thedrgreenthumb/dsPICAudioEffects/doc/dsPIC33AudioEffectsPedalPaper.pdf

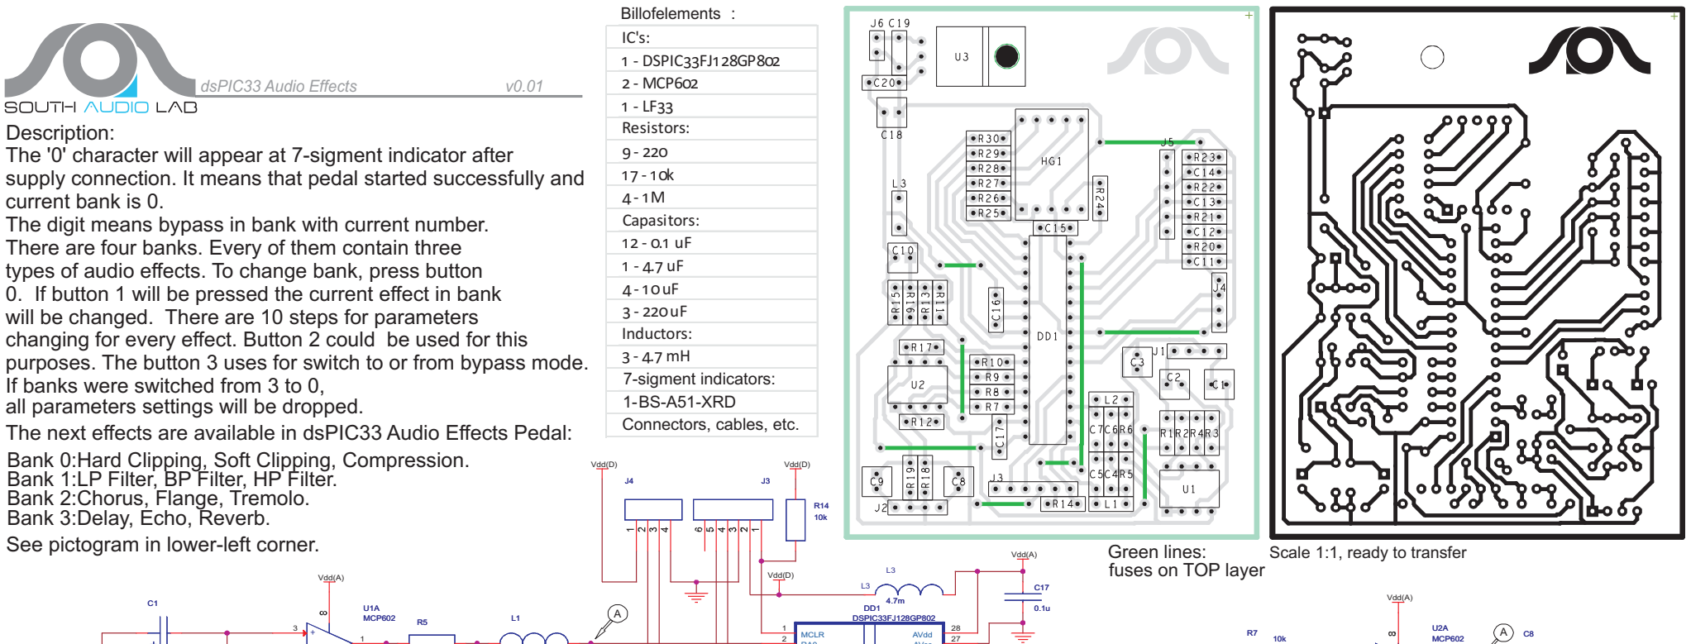
[picture p1: figure]
IC's: 1 - DSPIC33FJ128GP802 2 - MCP602 1 - LF33 Resistors: 9- 220 17 - 10k 4- 1Ì Capasitors: 12 - 0.1 uF 1 - 4.7 uF 4- 10uF 3 - 220uF Inductors: 3 - 4.7 mH; Green lines:; Scale 1:1, ready to transfer; fuses on TOP layer Vdd(A); Vdd(A); Vdd(D); DD1 DSPIC33FJ128GP802; U1A MCP602; Billofelements :; dsPIC33 Audio Effects; Bank 2:Chorus, Flange, Tremolo.; See pictogram in lower-left corner.; Description:; 7-sigment indicators: 1-BS-A51-XRD Connectors, cables, etc.; Bank 1:LP Filter, BP Filter, HP Filter.; Bank 3:Delay, Echo, Reverb.

Vdd(A)

Vdd(A)

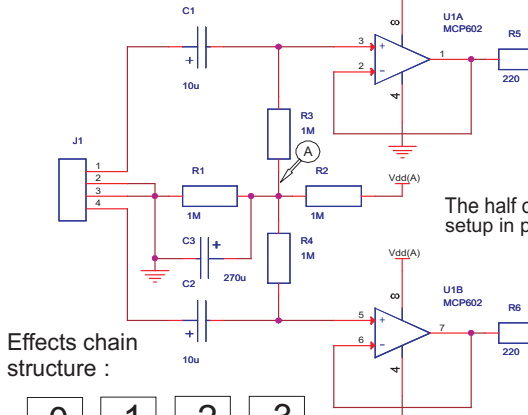
[picture p2: figure]
Vdd(A); U1B MCP602; Effects chain structure :

Vdd(D) | Vdd(D) | Vdd(D) | Vdd(D)

Vdd(D)

Vdd(D)

Vdd(D)

C4

0.1u

C9

10u

C20

0.1u

R20
10k

R26

220

C10

270u

R23
10k

+

MCP602
3

2

1

R30

220

C11

0.1u

C5

0.1u

R21
10k

R10
10k

C13

0.1u

MCLR
RA0

2

RA1

3

RB0/PGED1

4

RB1/PGEC1

5

RB2

6

RB3

7

Vss

8

OSC1/RA2

9

OSC2/RA3

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
15 RB7

16 RB8

17 RB9

18 Vss

19 Vddcore

20 RB10

21 RB11

22 RB12

23 RB13

24 RB14

25 RB15

26 AVss

27 AVdd

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
BS-A51XRD

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
0.1u

R27

220

J6

1
2

+

U2B
MCP602
5

6

7

C12

0.1u

C14

0.1u

+ | C18
| 270u

R16
10k

C7

0.1u

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
U3 LF33/TO220

VOUT

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
4.7m

C16

4.7u

C15

0.1u

R18
10k

C19

0.1u

L2

4.7m

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
J5 - Buttons.

J3 - ICSP.

*C16 ust be
ceramic

m

*

À

À

À

The half of supply voltage must be setup in points with character A

-C

-L
-E

-2

-F
-t

-C

The '0' character will appear at 7-sigment indicator after
supply connection. It means that pedal started successfully and current bank is 0.
The digit means bypass in bank with current number.
There are four banks. Every of them contain three
types of audio effects. To change bank, press button
0. If button 1 will be pressed the current effect in bank
will be changed. There are 10 steps for parameters
changing for every effect. Button 2 could be used for this purposes. The button 3 uses for switch to or from bypass mode. If banks were switched from 3 to 0,

The next effects are available in dsPIC33 Audio Effects Pedal: Bank 0:Hard Clipping, Soft Clipping, Compression.

all parameters settings will be dropped.

J4 - UART.
