thedrgreenthumb/dsPICAudioEffects/(list of files, drawings)

Other design files:
altium/final pedal1.PcbLib
altium/final pedal axial 03.PcbDoc
altium/final pedal.PcbDoc
altium/final pedal.PcbLib
altium/gui/gui.PcbDoc
altium/gui/gui.PcbLib
altium/gui/gui.PrjPcb
altium/gui/gui.SchDoc
altium/PCB1.PcbDoc
altium/pedala axial 03.SchDoc
altium/pedala.PcbDoc
altium/pedala.PrjPcb
altium/pedala.SchDoc
