thedrgreenthumb/dsPICAudioEffects/(commit log)

2013-07-23 First couple of chain positions need colibration, added and ranned flange. Chorus the next...
2013-07-28 There are sonme problems with colibration, related with filters in chain position 1. The filters will be deleted or fully redesigened.
    [MatlabDefs.h]
2014-04-06 The first effort to run were made, but xc16 not comatible with c30, deep fixing needed for indication in pedal
    [WM8510CodecDrv.c, WM8510CodecDrv.h, pedal_initialization.c, pedal_initialization.h]
2014-06-01 Runners have not crashed
    [pedal_initialization.c, pedal_initialization.h, pedal_main.c, pedal_processing.c, pedal_processing.h]
2014-06-03 Filters section added
2014-06-03 sc post-filter modification
2014-06-03 Filters section matlab precomputations
2014-06-11 Temporary fix for filters controlling
2014-06-11 Change sample rate in pedal project
2014-06-19 trying to add pre filter to HC
2014-06-24 Switch sk projects to GP506 MCU type
2015-10-13 Add Altium project
    [PCB1.PcbDoc, final pedal axial 03.PcbDoc, final pedal.PcbDoc, final pedal.PcbLib, final pedal1.PcbLib, gui.PcbDoc, gui.PcbLib, gui.PrjPcb]
